pprasse/diyBMSv4/ModuleV450/ModuleV450.png

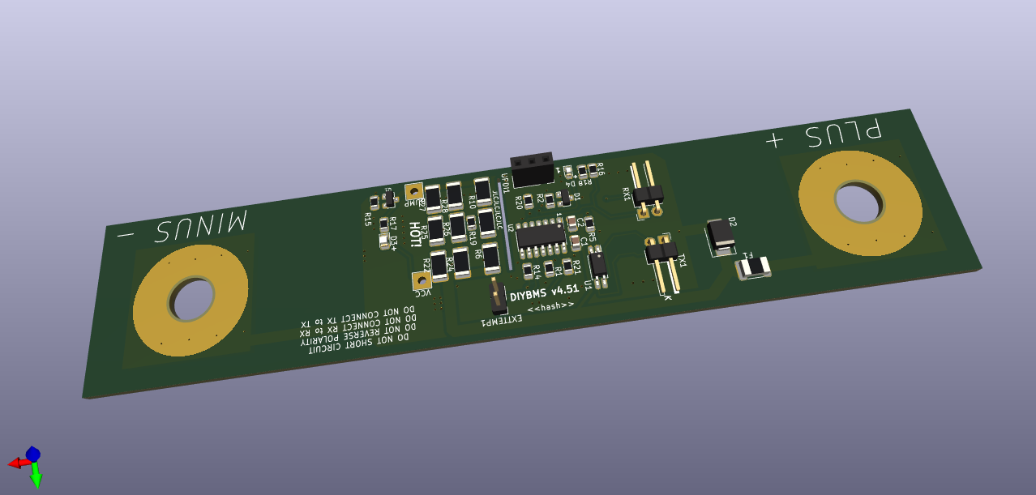
ModuleV450/ModuleV450.png
