pprasse/diyBMSv4/ModuleV440/ModuleV440.kicad_pcb

## KiCad design ModuleV440/ModuleV440.kicad_pcb (2023-09-22, an earlier design)

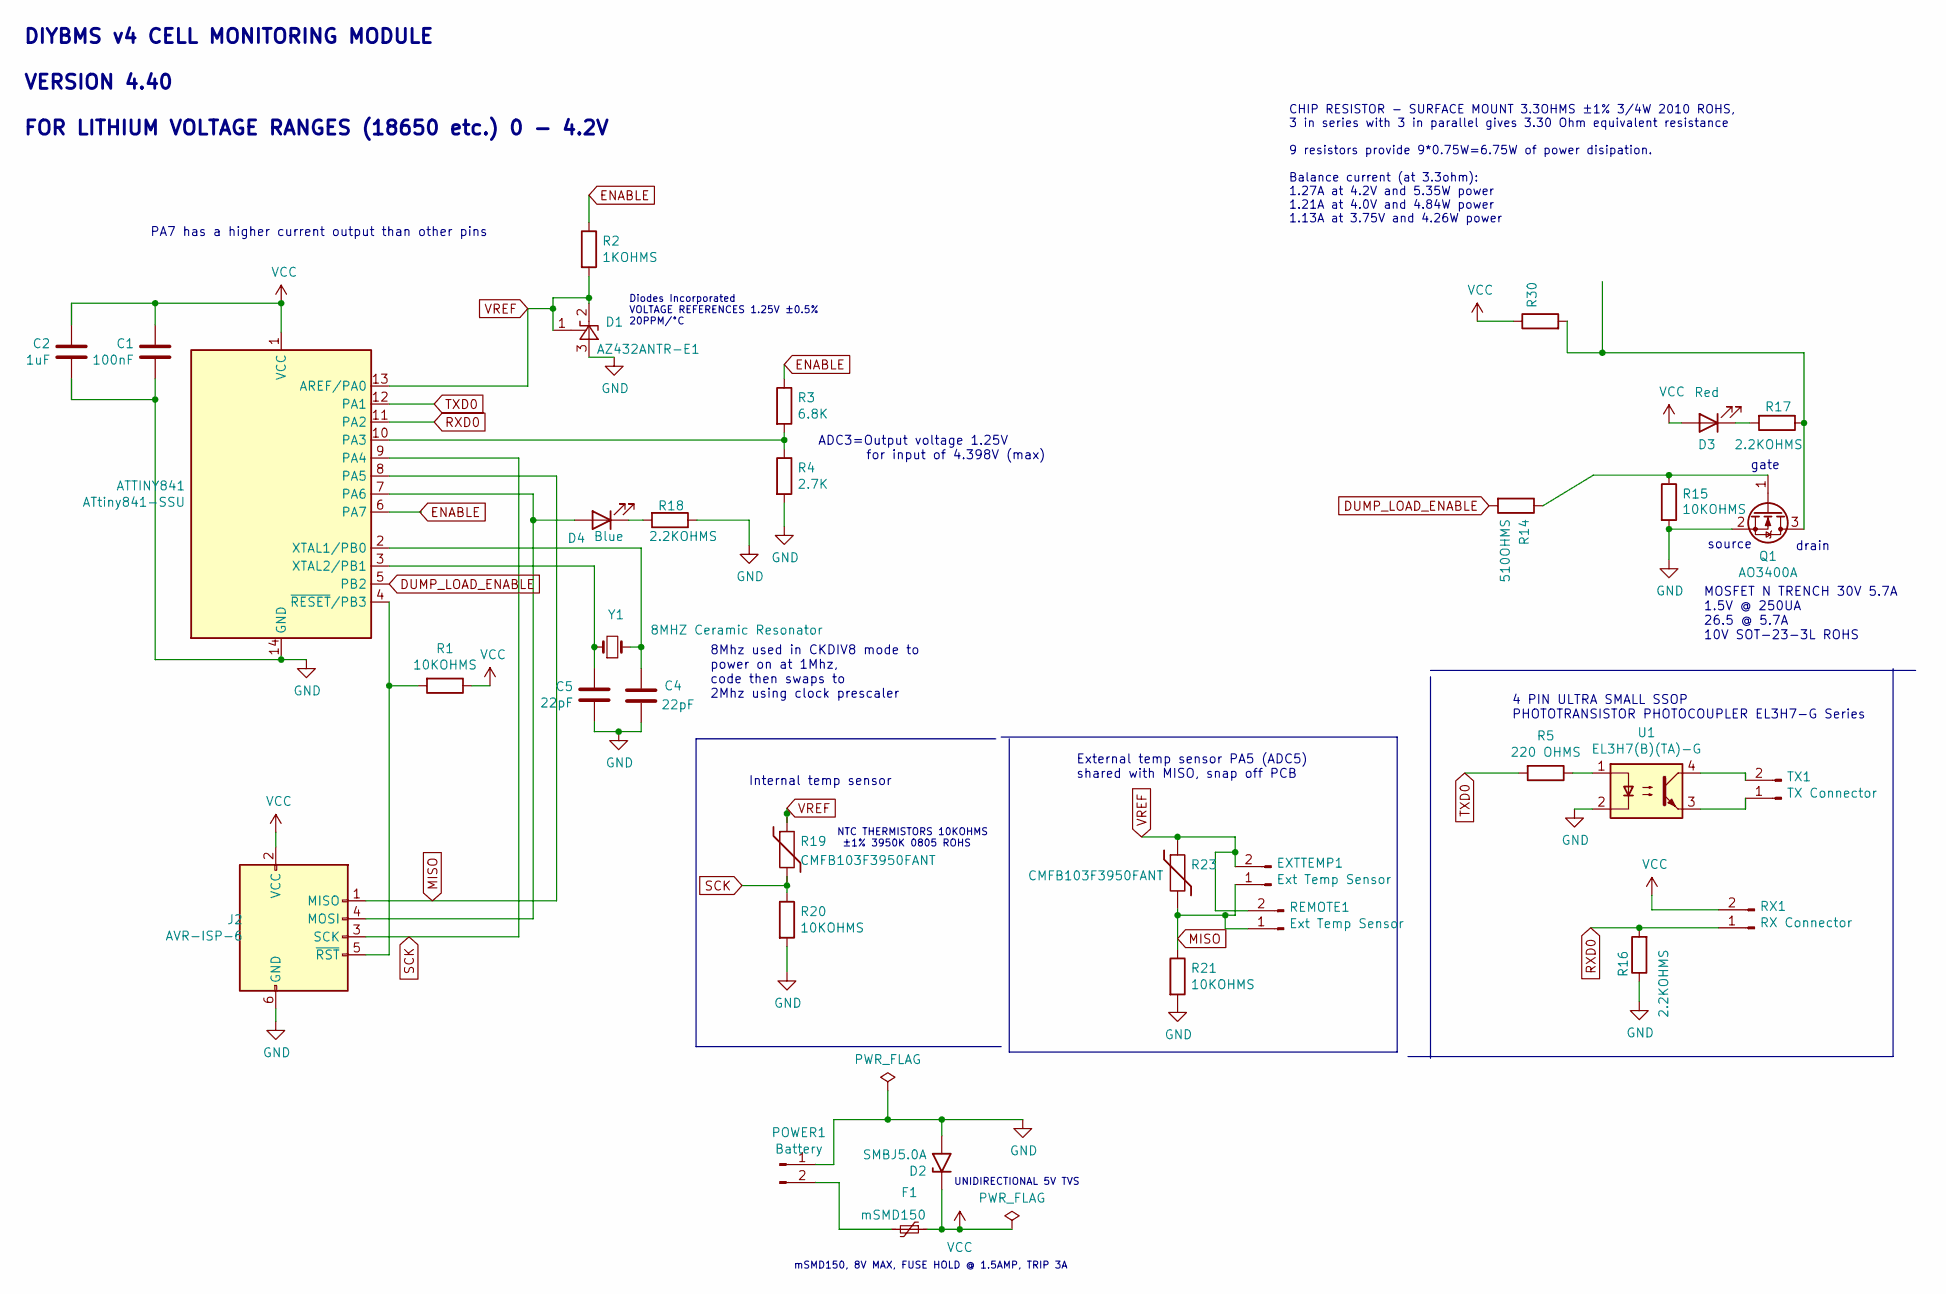
[picture p2: schematic ModuleV440.kicad_sch, DIYBMS cell monitoring module]

Parts:
ATTINY841: ATtiny841-SSU; SOIC-14_3.9x8.7mm_P1.27mm; LCSCStockCode C219103
C1: 100nF; C_0805_2012Metric; PartNumber CC0805KRX7R9BB104; LCSCStockCode C49678
C2: 1uF; C_0805_2012Metric; PartNumber CL21B105KBFNNNE; LCSCStockCode C28323
C4, C5: 22pF; C_0805_2012Metric; PartNumber CL21C220JBANNNC; LCSCStockCode C1804
D1: AZ432ANTR-E1; SOT-23; PartNumber AZ432ANTR-E1; LCSCStockCode C84139
D2: SMBJ5.0A; D_SMB; LCSCStockCode C440263
D3: Red; LED_0805_2012Metric; PartNumber 2012HRK-620D; LCSCStockCode C84256
D4: Blue; LED_0805_2012Metric; PartNumber Blue LED; LCSCStockCode C2293
EXTTEMP1: Ext Temp Sensor; JST_PH_S2B-PH-K_1x02_P2.00mm_Horizontal; PartNumber S2B-PH-K(LF)(SN); LCSCStockCode C265016
F1: mSMD150; Fuse_1812_4532Metric; PartNumber mSMD150; LCSCStockCode C70121
J2: AVR-ISP-6; Pin_Header_Straight_2x03_Pitch2.54mm; LCSCStockCode C65114
POWER1: Battery; JST_PH_S2B-PH-K_1x02_P2.00mm_Horizontal; PartNumber S2B-PH-K(LF)(SN); LCSCStockCode C265016
Q1: AO3400A; SOT-23; PartNumber AO3400A; LCSCStockCode C20917
R1, R15, R20, R21: 10KOHMS; R_0805_2012Metric; PartNumber 0805W8F1002T5E; LCSCStockCode C17414
R2: 1KOHMS; R_0805_2012Metric; PartNumber 0805W8F1001T5E; LCSCStockCode C17513
R3: 6.8K; R_0805_2012Metric; PartNumber 0805W8F6801T5E; LCSCStockCode C17772
R4: 2.7K; R_0805_2012Metric; PartNumber 0805W8F2701T5E; LCSCStockCode C17530
R5: 220 OHMS; R_0805_2012Metric; PartNumber 0805W8F2200T5E; LCSCStockCode C17557
R14: 510OHMS; R_0805_2012Metric; PartNumber 0805W8F5100T5E; LCSCStockCode C17734
R16, R17, R18: 2.2KOHMS; R_0805_2012Metric; PartNumber 0805W8F2201T5E; LCSCStockCode C17520
R19, R23: CMFB103F3950FANT; R_0805_2012Metric; PartNumber CMFB103F3950FANT; LCSCStockCode C51597
R30: 3.3OHM 3/4W; R_Radial_Power_L13.0mm_W9.0mm_P5.00mm; PartNumber SQMW53R3J
REMOTE1: Ext Temp Sensor; PinHeader_1x02_P2.54mm_Vertical
RX1: RX Connector; JST_PH_S2B-PH-K_1x02_P2.00mm_Horizontal; PartNumber S2B-PH-K(LF)(SN); LCSCStockCode C265016
TX1: TX Connector; JST_PH_S2B-PH-K_1x02_P2.00mm_Horizontal; PartNumber S2B-PH-K(LF)(SN); LCSCStockCode C265016
U1: EL3H7(B)(TA)-G; SOP-4_4.4x2.6mm_P1.27mm; PartNumber EL3H7(B)(TA)-G; LCSCStockCode C32565
Y1: 8MHZ Ceramic Resonator; Crystal_SMD_5032-2pin_5.0x3.2mm; PartNumber X50328MSB2GI; LCSCStockCode C115962

Connections:
DUMP_LOAD_ENABLE: ATTINY841.5 (PB2), R14.2
ENABLE: ATTINY841.6 (PA7), R2.1, R3.1
GND: ATTINY841.14 (GND), C1.2, C2.2, C4.2, C5.2, D1.3 (A), D2.2 (A2), J2.6 (GND), POWER1.1, Q1.2 (S), R4.2, R15.2, R16.1, R18.1, R20.2, R21.2, U1.2
MISO: ATTINY841.8 (PA5), EXTTEMP1.1, J2.1 (MISO), R21.1, R23.2, REMOTE1.1
unnamed: ATTINY841.10 (PA3), R3.2, R4.1
unnamed: ATTINY841.7 (PA6), D4.2 (A), J2.4 (MOSI)
unnamed: ATTINY841.2 (XTAL1/PB0), C4.1, Y1.2
unnamed: ATTINY841.3 (XTAL2/PB1), C5.1, Y1.1
unnamed: ATTINY841.4 (~RESET/PB3), J2.5 (~RST), R1.2
unnamed: D3.1 (K), R17.2
unnamed: D4.1 (K), R18.2
unnamed: F1.2, POWER1.2
unnamed: Q1.3 (D), R17.1, R30.2
unnamed: Q1.1 (G), R14.1, R15.1
unnamed: R5.1, U1.1
unnamed: TX1.1, U1.3
unnamed: TX1.2, U1.4
RXD0: ATTINY841.11 (PA2), R16.2, RX1.1
SCK: ATTINY841.9 (PA4), J2.3 (SCK), R19.2, R20.1
TXD0: ATTINY841.12 (PA1), R5.2
VCC: ATTINY841.1 (VCC), C1.1, C2.1, D2.1 (A1), D3.2 (A), F1.1, J2.2 (VCC), R1.1, R30.1, RX1.2
VREF: ATTINY841.13 (AREF/PA0), D1.1 (FB), D1.2 (K), EXTTEMP1.2, R2.2, R19.1, R23.1, REMOTE1.2

Notes on the sheet:
PA7 has a higher current output than other pins
CHIP RESISTOR - SURFACE MOUNT 3.3OHMS ±1% 3/4W 2010 ROHS, 3 in series with 3 in parallel gives 3.30 Ohm equivalent resistance 9 resistors provide 9*0.75W=6.75W of power disipation. Balance current (at 3.3ohm): 1.27A at 4.2V and 5.35W power 1.21A at 4.0V and 4.84W power 1.13A at 3.75V and 4.26W power
drain
mSMD150, 8V MAX, FUSE HOLD @ 1.5AMP, TRIP 3A
8Mhz used in CKDIV8 mode to power on at 1Mhz, code then swaps to 2Mhz using clock prescaler
4 PIN ULTRA SMALL SSOP PHOTOTRANSISTOR PHOTOCOUPLER EL3H7-G Series
ADC3=Output voltage 1.25V for input of 4.398V (max)
Diodes Incorporated VOLTAGE REFERENCES 1.25V ±0.5% 20PPM/°C
source
DIYBMS v4 CELL MONITORING MODULE VERSION 4.40 FOR LITHIUM VOLTAGE RANGES (18650 etc.) 0 - 4.2V
UNIDIRECTIONAL 5V TVS
NTC THERMISTORS 10KOHMS ±1% 3950K 0805 ROHS
gate
Internal temp sensor
External temp sensor PA5 (ADC5) shared with MISO, snap off PCB
MOSFET N TRENCH 30V 5.7A 1.5V @ 250UA 26.5 @ 5.7A 10V SOT-23-3L ROHS

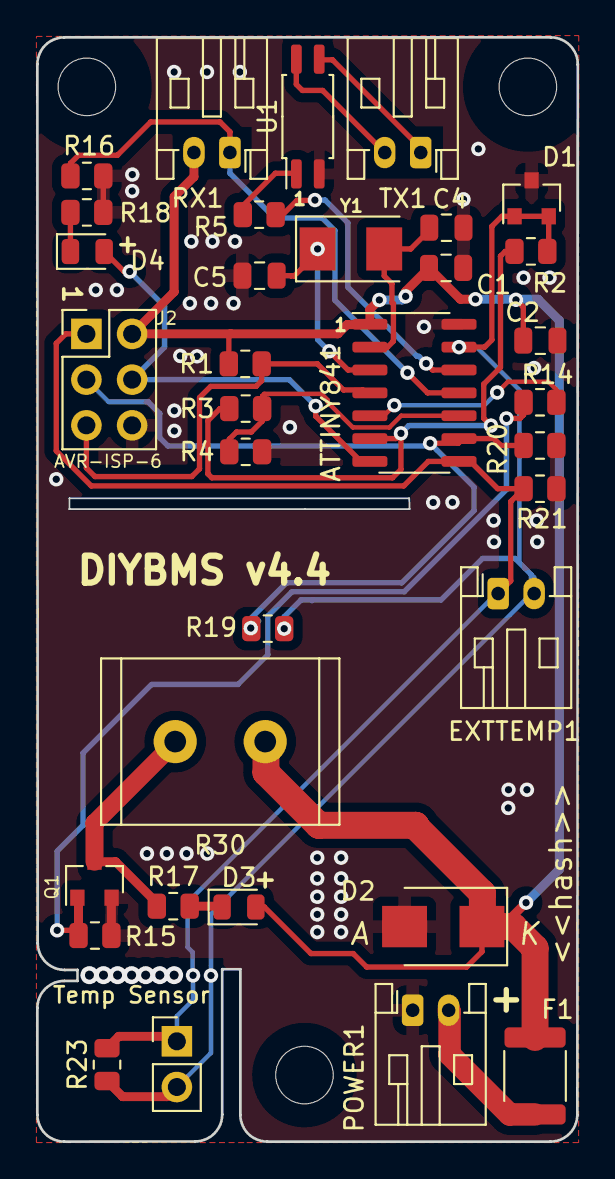
[picture p3: board ModuleV440.kicad_pcb from above]

Board: 2 copper layers, 30.0 x 61.3 mm, 34 parts (0 on the bottom side), 22 nets.
