pprasse/diyBMSv4/ControllerCircuit/ControllerCircuit.kicad_pcb

## KiCad design ControllerCircuit/ControllerCircuit.kicad_pcb (2023-09-22)

Schematic: ControllerCircuit.kicad_sch, DIYBMS ESP32 CONTROLLER

Parts:
C1, C2, C6, C8, C9: 100nF; C_0805_2012Metric; LCSCStockCode C49678
C3, C4: 22uF 6.3V; CP_EIA-3216-18_Kemet-A_Pad1.58x1.35mm_HandSolder; PartNumber TC212A226K006Y; LCSCStockCode C110786
C5: 22uF; C_1206_3216Metric; PartNumber CL31A226KPHNNNE; LCSCStockCode C5672
C7, C11: 1uF; C_0805_2012Metric; LCSCStockCode C28323
C10, C13: 1uF; C_0805_2012Metric; PartNumber CL21B105KBFNNNE; LCSCStockCode C28323
C12: 0.1uF-100V; C_0805_2012Metric; PartNumber C0805C104K1RECAUTO; LCSCStockCode C696367
C14: 100nF; C_0805_2012Metric; PartNumber CC0805KRX7R9BB104; LCSCStockCode C49678
D1: RGB; LED_RGB_5050-6; LCSCStockCode C219409
D2, D5: LL4148; D_MiniMELF; PartNumber LL4148; LCSCStockCode C9808
D3, D4: YELLOW LED; LED_0603_1608Metric_Pad1.05x0.95mm_HandSolder; LCSCStockCode C72038
D6: MHPC3528CRGBCT; LED_MHPC3528CRGBCT
D8: NUP2105LT1G; SOT-23; LCSCStockCode C2976509
F1: Fuse, 1.85A; Fuse_2920_7451Metric; PartNumber TLC-LSMD185; LCSCStockCode C262041
J1, J4, J7, J12: ScrewTerminal; Terminal-Block_3.81_4P_LCSC_C395880; LCSCStockCode C395880
J2, J3: ScrewTerminal3Pin; Terminal-Block_5.0mm_3P-LCSC_C395850; LCSCStockCode C395850
J5: ScrewTerminal; Terminal-Block_3.81_2P-LCSC_C395878; LCSCStockCode C395878
J8: 2x3 2.54mm IDC Connectors; PinHeader_2x03_P2.54mm_Vertical; LCSCStockCode C132438
J9: Shunt; Terminal-Block_3.81_4P_LCSC_C395880; LCSCStockCode C395880
J10: Conn_01x02_Female; PinHeader_1x02_P2.54mm_Horizontal; LCSCStockCode C376120
J14: Unused header; PinHeader_1x07_P2.54mm_Vertical
J15: Molex 0472192001; 0472192001; Manufacturer_Part_Number 0472192001; Mouser Part Number N/A
JP1: OptTermination; SolderJumper-2_P1.3mm_Bridged_Pad1.0x1.5mm
JP4: OptTermination; SolderJumper-2_P1.3mm_Bridged_RoundedPad1.0x1.5mm
K1, K2: SRD-05VDC-SL-C; RELAY_SRD-05VDC-SL-C; PartNumber SRD-05VDC-SL-C; LCSCStockCode C35449
LCD1: LCD; TFTSPI_2_8_240x320_TOUCH; LCSCStockCode C52711/C358718
Q1, Q2, Q4: AO3400A; SOT-23; PartNumber AO3400A; LCSCStockCode C344010
Q3: AO3401A; SOT-23; LCSCStockCode C15127
R1, R17, R18, R21, R25: 220R; R_0805_2012Metric; PartNumber 0805W8F2200T5E; LCSCStockCode C17557
R2, R5, R16: 2K2; R_0805_2012Metric; PartNumber 0805W8F2201T5E; LCSCStockCode C17520
R3: 180R; R_0805_2012Metric; PartNumber 0805W8F1800T5E; LCSCStockCode C25270
R4, R10, R12, R13, R14: 560R; R_0805_2012Metric; PartNumber 0805W8F5600T5E; LCSCStockCode C28636
R6, R8, R9: 120R; R_0805_2012Metric; PartNumber 0805W8F1200T5E; LCSCStockCode C17437
R7, R11, R15, R27: 51K; R_0805_2012Metric; PartNumber 0805W8F5102T5E; LCSCStockCode C17737
R19, R22, R29, R31, R32: 10K; R_0805_2012Metric; PartNumber 0805W8F1002T5E; LCSCStockCode C17414
R20: 1M; R_0805_2012Metric; PartNumber 0805W8F1004T5E; LCSCStockCode C17514
R23, R30: 10R; R_0805_2012Metric; PartNumber 0805W8F100JT5E; LCSCStockCode C17415
R24, R26, R28: 22K; R_0805_2012Metric; PartNumber 0805W8F2202T5E; LCSCStockCode C17560
RX1: Receive; JST_PH_S2B-PH-K_1x02_P2.00mm_Horizontal; PartNumber S2B-PH-K-S-GW; LCSCStockCode C157932
SW1, SW2: SW_Push; SW_PUSH_6mm_H5mm; PartNumber XUNPU TS-1002-10026; LCSCStockCode C455101
TX1: Transmit; JST_PH_S2B-PH-K_1x02_P2.00mm_Horizontal; PartNumber S2B-PH-K-S-GW; LCSCStockCode C157932
U1: TXS0102DCU; VSSOP-8_2.3x2mm_P0.5mm; LCSCStockCode C53434
U2: EL3H7(B)(TA)-G; SOP-4_4.4x2.6mm_P1.27mm; LCSCStockCode C32565
U3: TCA6416APWR; TSSOP-24_4.4x7.8mm_P0.65mm; LCSCStockCode C130203
U4: ESP32-DEVKITC-32D; MODULE_ESP32-DEVKITC-32D; LCSCStockCode C319202/C319202
U5: SN65HVD75DR; SOIC-8_3.9x4.9mm_P1.27mm; PartNumber SN65HVD75DR; LCSCStockCode C57928
U6: AMS1117-3.3; SOT-223-3_TabPin2; PartNumber AMS1117-3.3; LCSCStockCode C6186
U7: SN65HVD1050D; SOIC-8_3.9x4.9mm_P1.27mm; LCSCStockCode C14019
U8: INA229; VSSOP-10_3x3mm_P0.5mm; PartNumber INA229AIDGSR; LCSCStockCode C2846803
U9, U12: AQY282SX; SO-4_4.4x3.6mm_P2.54mm; LCSCStockCode C250827

Connections:
+5V: F1.2, J5.1
/AVRISP_RESET: J8.5 (~RST), U4.33 (IO0)
/BLUE_LED: R1.2, U3.13 (P10)
/CANBUS_RX: U1.4 (A2), U4.30 (IO17)
/CANBUS_TX: U1.5 (A1), U4.31 (IO16)
/DISPLAY_DC: LCD1.10 (D/C), U4.35 (IO15)
/DISPLAY_LED: R21.2, U3.16 (P13)
/EXT_IO_A: J4.1, U3.4 (P0)
/EXT_IO_B: J4.2, U3.5 (P1)
/EXT_IO_C: J4.3, U3.6 (P2)
/EXT_IO_D: J4.4, U3.7 (P3)
/GREEN_LED: R17.2, U3.15 (P12)
/HSPI_CLK: LCD1.8 (SCK), U4.12 (IO14)
/HSPI_MISO: LCD1.6 (MISO), U4.13 (IO12)
/HSPI_MOSI: LCD1.9 (MOSI), U4.15 (IO13)
/IO2: Q4.3 (D), R20.1, U4.34 (IO2)
/IO4: LCD1.4 (T_CS), U4.32 (IO4)
/IO5: J15.2 (CD/DAT3), LCD1.SD4 (SD_CS), R22.1, U4.29 (IO5)
/IO21: U4.25 (IO21), U5.1 (R)
/IO22: U4.22 (IO22), U5.4 (D)
/IO25: U4.9 (IO25), U5.2 (RE), U5.3 (DE)
/IO26: R5.1, U3.22 (SCL), U4.10 (IO26)
/IO27: R16.1, U3.23 (SDA), U4.11 (IO27)
/IO32: R3.2, U4.7 (IO32)
/IO33: R31.1, U4.8 (IO33), U8.1 (CS)
/IO34_INPUT: J14.4, U4.5 (IO34)
/IO35_INPUT: R32.2, U4.6 (IO35), U8.3 (~Alert)
/IO36_INPUT: LCD1.1 (T_IRQ), U4.3 (SENSOR_VP)
/IO39_INPUT: R19.1, U3.1 (~INT), U4.4 (SENSOR_VN)
/RED_LED: R4.2, U3.14 (P11)
/RELAY1: R10.2, U3.8 (P4)
/RELAY2: R14.2, U3.9 (P5)
/RELAY3_SSR: R18.2, U3.10 (P6)
/RELAY4_SSR: R25.2, U3.11 (P7)
/RESET: LCD1.11 (RESET), R29.1, U3.3 (~RESET), U4.2 (EN)
/SW1EXT: J14.5, R7.1, R26.2, SW1.1
/SW1OUTPUT: C7.1, R26.1, U3.17 (P14)
/SW2EXT: J14.6, R27.1, R28.2, SW2.1
/SW2OUTPUT: C11.1, R28.1, U3.19 (P16)
/VSPI_CLK: J8.3 (SCK), J15.5 (CLK), LCD1.5 (T_CLK), LCD1.SD1 (SD_SCK), U4.28 (IO18), U8.5 (SCLK)
/VSPI_MISO: J8.1 (MISO), J15.7 (DAT0), LCD1.2 (T_DO), LCD1.SD2 (SD_MISO), U4.27 (IO19), U8.4 (MISO)
/VSPI_MOSI: J8.4 (MOSI), J15.3 (CMD), LCD1.3 (T_DIN), LCD1.SD3 (SD_MOSI), U4.21 (IO23), U8.2 (MOSI)
FUSED5V: C2.1, C3.1, C5.2, C9.1, D2.1 (K), D5.1 (K), J1.1, J7.1, K1.A1, K2.A1, Q3.2 (S), R7.2, R12.2, R13.2, R24.2, R27.2, U1.7 (VCCB), U3.21 (ADDR), U3.24 (VCCP), U4.19 (EXT_5V), U6.3 (VI), U7.3 (VCC)
GND: C1.2, C2.2, C3.2, C4.2, C5.1, C6.2, C7.2, C8.1, C9.2, C10.2, C11.2, C13.1, C14.1, D1.4 (BA), D1.5 (GA), D1.6 (RA), D6.4, D8.3 (A), J1.4, J5.2, J7.2, J8.6 (GND), J10.2, J14.7, J15.6 (VSS), J15.G1 (GND_1), J15.G2 (GND_2), J15.G3 (GND_3), J15.G4 (GND_4), LCD1.12 (CS), LCD1.13 (GND), Q1.2 (S), Q2.2 (S), Q4.2 (S), R8.2, R11.1, R15.1, RX1.1, SW1.2, SW2.2, U1.2 (GND), U2.2, U3.12 (GND), U4.14 (GND1), U4.20 (GND3), U4.26 (GND2), U5.5 (GND), U6.1 (GND), U7.2 (GND), U7.8 (S), U8.7 (GND), U9.2, U12.2
unnamed: C12.1, R23.1, U8.10 (Vin+)
unnamed: C12.2, R30.1, U8.9 (Vin-)
unnamed: D1.1 (RK), D6.3, R17.1
unnamed: D1.2 (GK), D6.1, R4.1
unnamed: D1.3 (BK), D6.2, R1.1
unnamed: D2.2 (A), D3.1 (K), K1.A2, Q1.3 (D)
unnamed: D3.2 (A), R12.1
unnamed: D4.1 (K), D5.2 (A), K2.A2, Q2.3 (D)
unnamed: D4.2 (A), R13.1
unnamed: D8.1 (K), J7.4, JP1.1 (A), U7.6 (CANL)
unnamed: D8.2 (K), J7.3, R6.2, U7.7 (CANH)
unnamed: F1.1, Q3.3 (D)
unnamed: J1.2, R9.1, U5.6 (A)
unnamed: J1.3, JP4.1 (A), U5.7 (B)
unnamed: J2.1, K1.COM
unnamed: J2.2, K1.NC
unnamed: J2.3, K1.NO
unnamed: J3.1, K2.COM
unnamed: J3.2, K2.NC
unnamed: J3.3, K2.NO
unnamed: J9.1, R30.2
unnamed: J9.2, R23.2
unnamed: J9.4, U8.8 (Vbus)
unnamed: J10.1, R24.1, U3.20 (P17)
unnamed: J12.1, U9.3
unnamed: J12.2, U9.4
unnamed: J12.3, U12.3
unnamed: J12.4, U12.4
unnamed: JP1.2 (B), R6.1
unnamed: JP4.2 (B), R9.2
unnamed: LCD1.7 (LED), R21.1
unnamed: Q1.1 (G), R10.1, R11.2
unnamed: Q2.1 (G), R14.1, R15.2
unnamed: Q3.1 (G), R8.1
unnamed: Q4.1 (G), R2.1, RX1.2
unnamed: R3.1, U2.1
unnamed: R18.1, U9.1
unnamed: R25.1, U12.1
unnamed: TX1.1, U2.3
unnamed: TX1.2, U2.4
unnamed: U1.1 (B2), U7.4 (RXD)
unnamed: U1.8 (B1), U7.1 (TXD)

Notes on the sheet:
PIN 1 is an output (received data). RS485 half duplex IC required.
ILI9341
Provides 5V I/O pins for external interfaces and relays, up to 10mA per port. i2c address 0x21 (ADDR is high)
Power input
CANBUS
Standard Module comms
BATTERY+
The pins GPIO16 and GPIO17 are available for use only on the boards with the modules ESP32-WROOM and ESP32-SOLO-1. The boards with ESP32-WROVER modules have the pins reserved for internal use.
1=USB SERIAL 3=USB SERIAL 6=N/A 7=N/A 8=N/A 9=[NOT AVAILABE ON DEVKIT] mapped to IO16 on DEVKIT 10=[NOT AVAILABE ON DEVKIT] mapped to IO17 on DEVKIT 11=N/A 12=DISPLAY HSPI MISO / MTDI/GPIO12: internal pull-down 13=DISPLAY HSPI MOSI 14=DISPLAY HSPI CLK 16=SEE IO9 17=SEE IO10 18= VSPI_CLK (CONFIRMED)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
This work is licensed under a Creative Commons Attribution-NonCommercial-ShareAlike 2.0 UK: England & Wales License. https://creativecommons.org/licenses/by-nc-sa/2.0/uk/ You are free to: Share — copy and redistribute the material in any medium or format Adapt — remix, transform, and build upon the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
VBUS
120R optional resistor for termination, CONNECTED by default
Connected to USB port
LCD SCREEN = 42mA (including backlight @ 2.5mA)
Emergency stop button (pulled high)
ESP32 Strapping Pins GPIO0, GPIO5 and GPIO15 have pull-up resistors enabled during power up. GPIO2 and GPIO12 have pull-down resistors enabled during power up. These pull-up and pull-down resistors can be disabled via software once the device is running. The ESP32 will enter the serial bootloader w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
Panasonic AQY282SX Solid State Relay 60V 500mA AC or DC
MICRO SD CARD
Flyback diode calc Relay, 5VDC = 72mA 70ohm+/-10% 0.36W LL4148, Peak Reverse Voltage 100V Peak Fwd Surge Current 0.5A @1s, 1A@1ms Power Dissipation 500mW
DUAL FOOT PRINT - ONLY FIT 1 LED!
LCSC C2962096
Push buttons with de-bounce
Changes: CANBUS_S has been removed, hard wired to low LED output resistor values changed to cater for 5v
CHARGER/LOAD
POWER CONSUMPTION
Display is only item on bus so no CS needed
IO34 used on previous controller versions as TCA9534A_INTERRUPT_PIN
120R optional resistor for CAN termination, CONNECTED by default
i2c pull up resistors
Non-Commercial — You may not use the material for commercial purposes.
PIN MAPPING
Reverse polarity protection
Consider using part C8387 WJ15EDGRC-3.81-2P Pluggable System Terminal Block 3.81mm
Green/Red intentionally swapped to match component + ground! (foot print wrong)
RS-485
Using 4 pin connector to reduce part count
ONBOARD CURRENT SHUNT/MONITOR

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
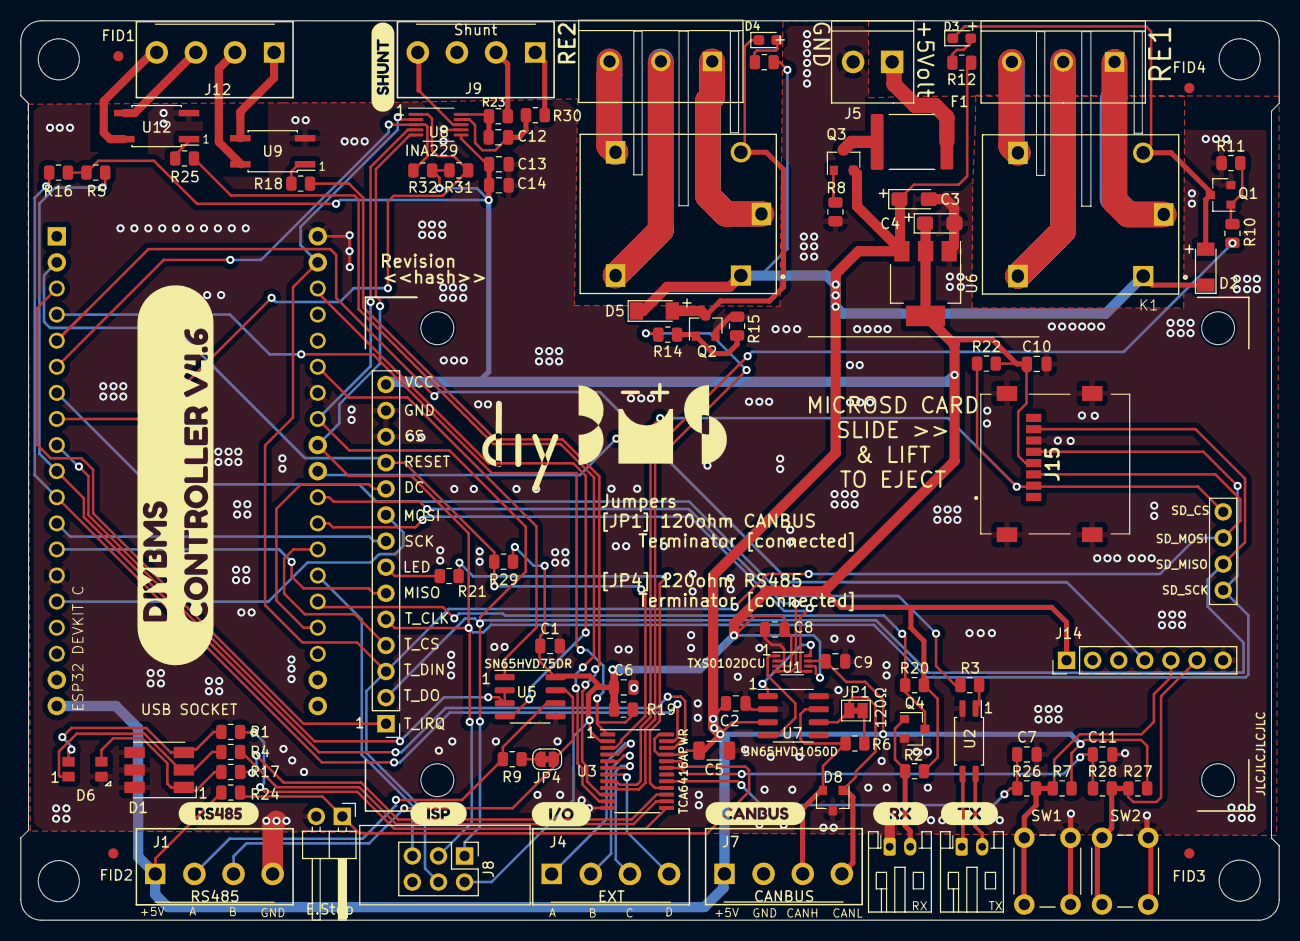
[picture p6: board ControllerCircuit.kicad_pcb from above]

Board: 2 copper layers, 122.5 x 87.5 mm, 102 parts (1 on the bottom side), 87 nets.

Other parts of the board:
FID1, FID2, FID3, FID4: Fiducial_1mm_Mask2mm
e: LOGO; logo
svg2mod, svg2mod#2, svg2mod#3, svg2mod#4, svg2mod#5, svg2mod#6, svg2mod#7, svg2mod#8: G***; label
