pprasse/diyBMSv4/(notices)

Notices in the files:
ControllerCircuit/ControllerCircuit.kicad_pcb:
©2019 to 2023 Stuart Pittaway
ModuleV450/ModuleV450.kicad_pcb:
©2019-2022
